Aleksei521/humidity-measure/image/board_up.jpg

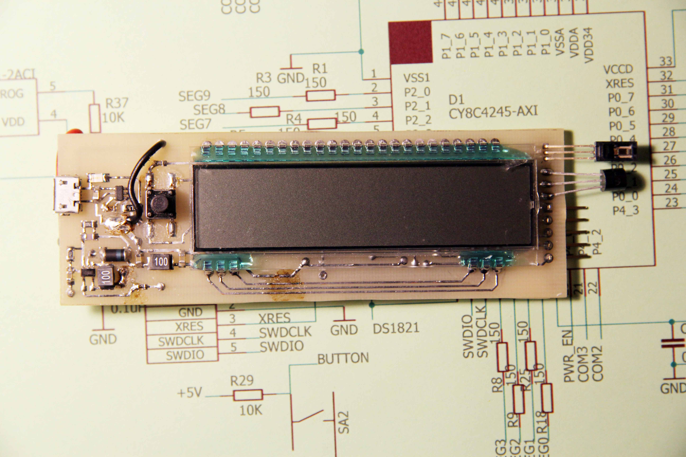
image/board_up.jpg
