Aleksei521/humidity-measure/image/board_back.jpg

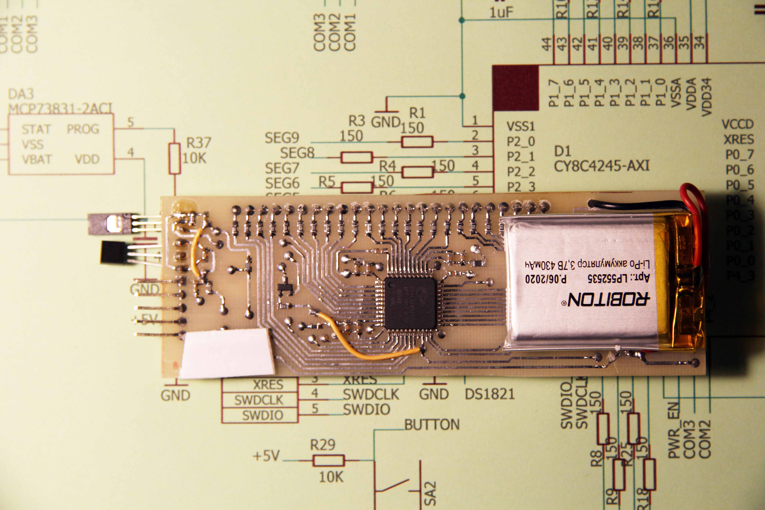
image/board_back.jpg
