Aleksei521/humidity-measure/README.md

# humidity-measure
Moisture and temperature meter on PSOC 4200 and segment LCD
https://habr.com/ru/post/547644/#habracut
