Aleksei521/humidity-measure/image/equip.jpg

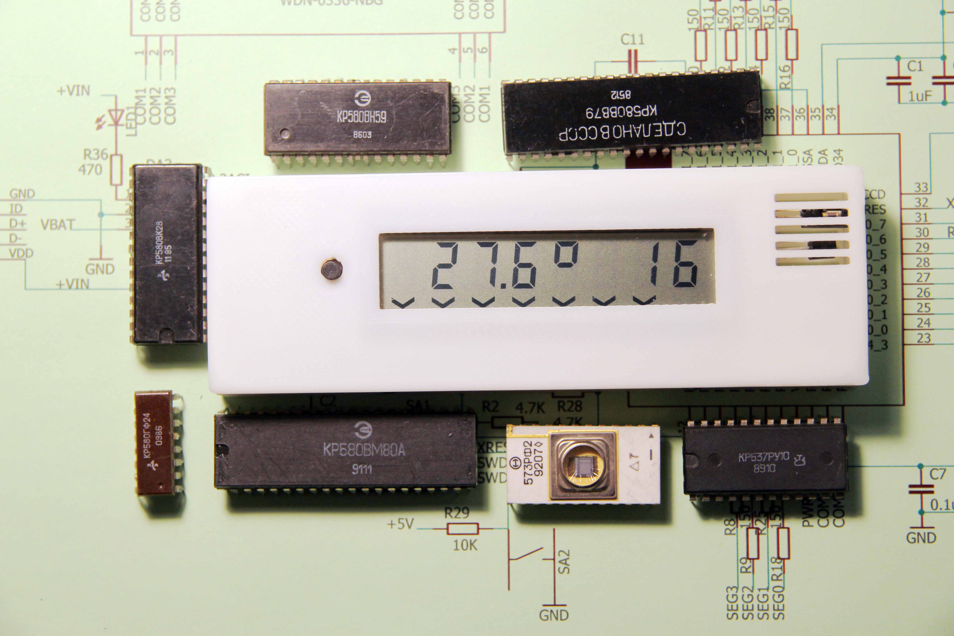
image/equip.jpg
