Aleksei521/humidity-measure/image/schematic.png

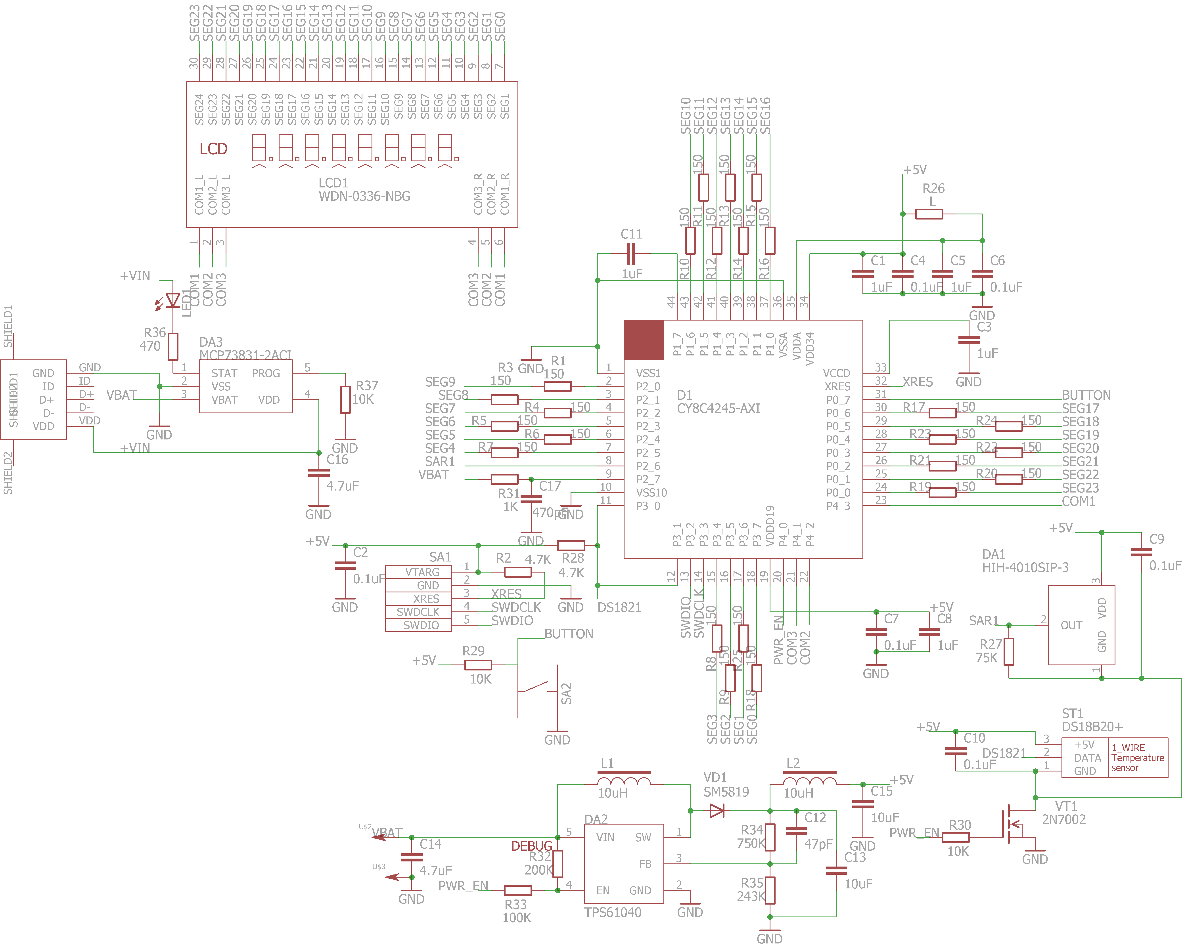
image/schematic.png
