Aleksei521/humidity-measure/Eagle/mcu.brd

## EAGLE design Eagle/mcu.brd (2021-03-17)

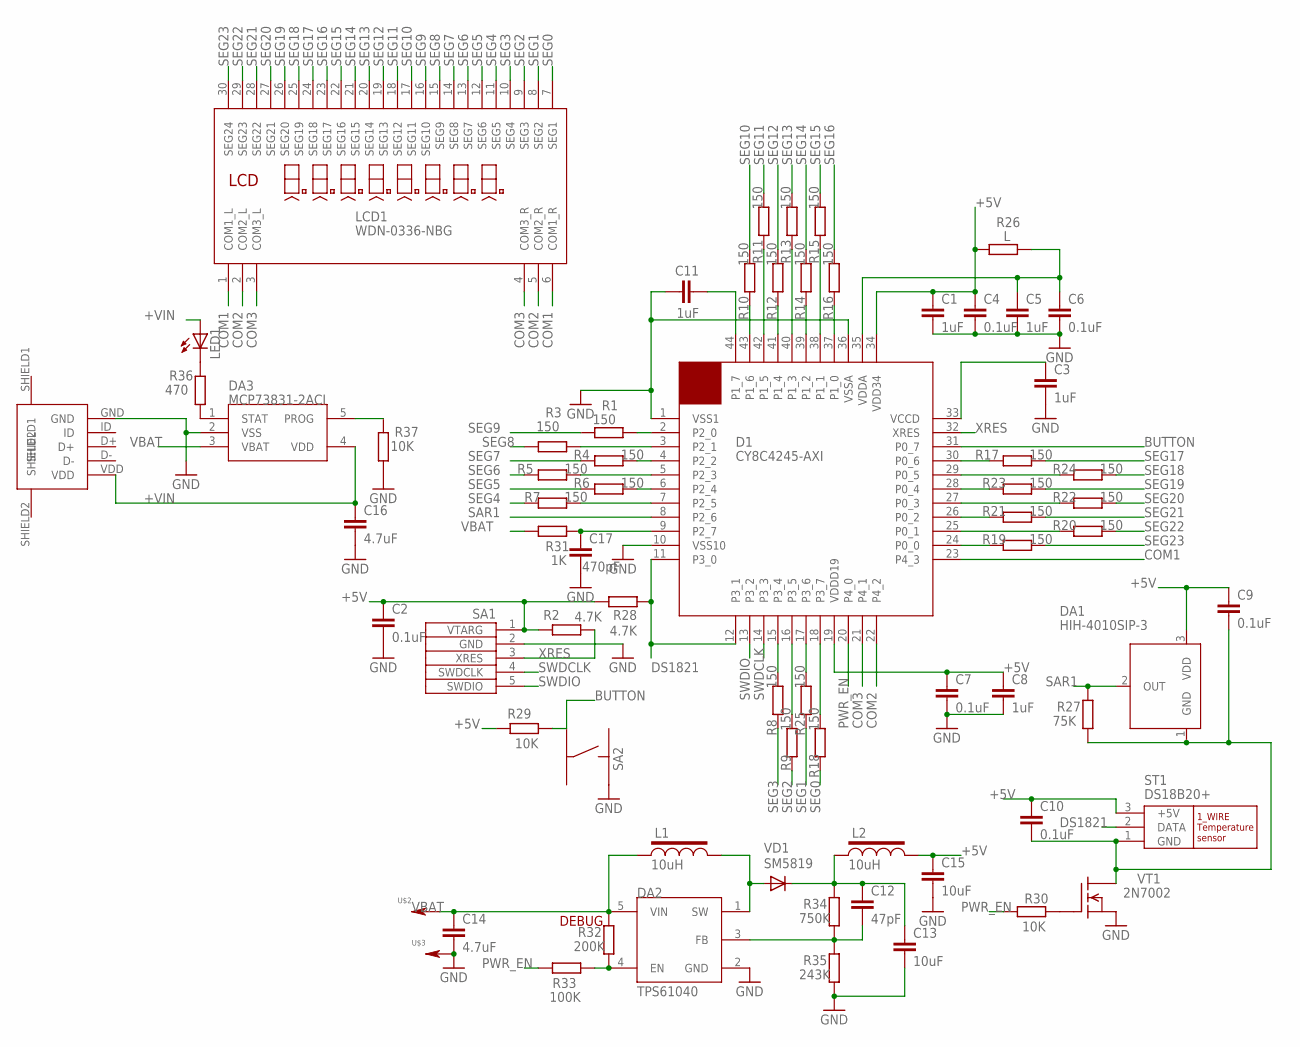
[picture p5: schematic mcu.sch]

Parts:
C1, C3, C5, C8, C11: 1uF; C0603
C2, C4, C6, C7, C9, C10: 0.1uF; C0603
C12: 47pF; C0805
C13, C15: 10uF; C0805
C14, C16: 4.7uF; C0805
C17: 470pF; C0603
D1: CY8C4245-AXI; TQFP44
DA1: HIH-4010SIP-3; SIP-3
DA2: TPS61040; SOT23-5L
DA3: MCP73831-2ACI; SOT23-5L
L1, L2: 10uH; SQC453226
LCD1: WDN-0336-NBG; WDN0336
LED1: LEDSMT1206; 1206
R1, R3, R4, R5, R6, R7, R8, R9, R10, R11, R12, R13, R14, R15, R16, R17, R18, R19, R20, R21, R22, R23, R24, R25: 150; R0603
R2, R28: 4.7K; R0603
R26: L; R0805
R27: 75K; R0603
R29, R30, R37: 10K; R0603
R31: 1K; R0603
R32: 200K; R0603
R33: 100K; R0603
R34: 750K; R0805
R35: 243K; R0805
R36: 470; R1206
SA1: SWDSWD-5; SWD-5
SA2: TACKT_BUTTONIIT-1102S; IIT-1102S
ST1: DS18B20+; TO92-
U$1: USB-MICRO; USB-MICRO-SMD
U$2: 1-PINHOME; 1-PIN_HOME
U$3: 1-PIN2_54; 1_PIN_2_54
VD1: SM5819; MELF-MLL41
VT1: 2N7002; SOT23

Connections:
+5V: C1.1, C2.1, C4.1, C7.1, C8.1, C9.1, C10.1, C15.1, D1.19 (VDDD19), D1.34 (VDD34), DA1.3 (VDD), L2.2 (L2), R2.2, R26.1, R28.2, R29.2, SA1.1 (VTARG), ST1.3 (+5V)
+VIN: C16.1, DA3.4 (VDD), LED1.A, U$1.VDD
BUTTON: D1.31 (P0_7), R29.1, SA2.SSR (2)
COM1: D1.23 (P4_3), LCD1.1 (COM1_L), LCD1.6 (COM1_R)
COM2: D1.22 (P4_2), LCD1.2 (COM2_L), LCD1.5 (COM2_R)
COM3: D1.21 (P4_1), LCD1.3 (COM3_L), LCD1.4 (COM3_R)
DS1821: D1.11 (P3_0), D1.12 (P3_1), R28.1, ST1.2 (DATA)
GND: C1.2, C2.2, C3.2, C4.2, C5.2, C6.2, C7.2, C8.2, C11.1, C13.2, C14.2, C15.2, C16.2, C17.2, D1.1 (VSS1), D1.10 (VSS10), D1.36 (VSSA), DA2.2 (GND), DA3.2 (VSS), R35.1, R37.1, SA1.2 (GND), SA2.SL (3), U$1.GND, U$3.P$1, VT1.2 (S)
unnamed: D1.2 (P2_0), R1.2
unnamed: D1.4 (P2_2), R4.2
unnamed: D1.6 (P2_4), R6.2
unnamed: D1.15 (P3_4), R8.2
unnamed: D1.3 (P2_1), R3.2
unnamed: D1.5 (P2_3), R5.2
unnamed: D1.7 (P2_5), R7.2
unnamed: D1.43 (P1_6), R10.1
unnamed: C3.1, D1.33 (VCCD)
unnamed: D1.42 (P1_5), R11.1
unnamed: D1.41 (P1_4), R12.1
unnamed: C5.1, C6.1, D1.35 (VDDA), R26.2
unnamed: D1.40 (P1_3), R13.1
unnamed: D1.39 (P1_2), R14.1
unnamed: D1.38 (P1_1), R15.1
unnamed: D1.37 (P1_0), R16.1
unnamed: D1.30 (P0_6), R17.1
unnamed: D1.29 (P0_5), R24.1
unnamed: D1.28 (P0_4), R23.1
unnamed: D1.16 (P3_5), R9.2
unnamed: D1.17 (P3_6), R25.2
unnamed: D1.18 (P3_7), R18.2
unnamed: D1.27 (P0_3), R22.1
unnamed: D1.26 (P0_2), R21.1
unnamed: D1.25 (P0_1), R20.1
unnamed: D1.24 (P0_0), R19.1
unnamed: C11.2, D1.44 (P1_7)
unnamed: C9.2, C10.2, DA1.1 (GND), R27.1, ST1.1 (GND), VT1.3 (D)
unnamed: R30.2, VT1.1 (G)
unnamed: C12.2, DA2.3 (FB), R34.1, R35.2
unnamed: DA2.4 (EN), R32.1, R33.2
unnamed: DA2.1 (SW), L1.2 (L2), VD1.A
unnamed: C12.1, C13.1, L2.1 (L1), R34.2, VD1.C
unnamed: DA3.1 (STAT), R36.1
unnamed: LED1.C, R36.2
unnamed: DA3.5 (PROG), R37.2
PWR_EN: D1.20 (P4_0), R30.1, R33.1
SAR1: D1.8 (P2_6), DA1.2 (OUT), R27.2
SAR2: C17.1, D1.9 (P2_7), R31.2
SEG0: LCD1.7 (SEG1), R18.1
SEG1: LCD1.8 (SEG2), R25.1
SEG2: LCD1.9 (SEG3), R9.1
SEG3: LCD1.10 (SEG4), R8.1
SEG4: LCD1.11 (SEG5), R7.1
SEG5: LCD1.12 (SEG6), R6.1
SEG6: LCD1.13 (SEG7), R5.1
SEG7: LCD1.14 (SEG8), R4.1
SEG8: LCD1.15 (SEG9), R3.1
SEG9: LCD1.16 (SEG10), R1.1
SEG10: LCD1.17 (SEG11), R10.2
SEG11: LCD1.18 (SEG12), R11.2
SEG12: LCD1.19 (SEG13), R12.2
SEG13: LCD1.20 (SEG14), R13.2
SEG14: LCD1.21 (SEG15), R14.2
SEG15: LCD1.22 (SEG16), R15.2
SEG16: LCD1.23 (SEG17), R16.2
SEG17: LCD1.24 (SEG18), R17.2
SEG18: LCD1.25 (SEG19), R24.2
SEG19: LCD1.26 (SEG20), R23.2
SEG20: LCD1.27 (SEG21), R22.2
SEG21: LCD1.28 (SEG22), R21.2
SEG22: LCD1.29 (SEG23), R20.2
SEG23: LCD1.30 (SEG24), R19.2
SWDCLK: D1.14 (P3_3), SA1.4 (SWDCLK)
SWDIO: D1.13 (P3_2), SA1.5 (SWDIO)
VBAT: C14.1, DA2.5 (VIN), DA3.3 (VBAT), L1.1 (L1), R31.1, R32.2, U$2.P$1
XRES: D1.32 (XRES), R2.1, SA1.3 (XRES)

Notes on the sheet:
DEBUG

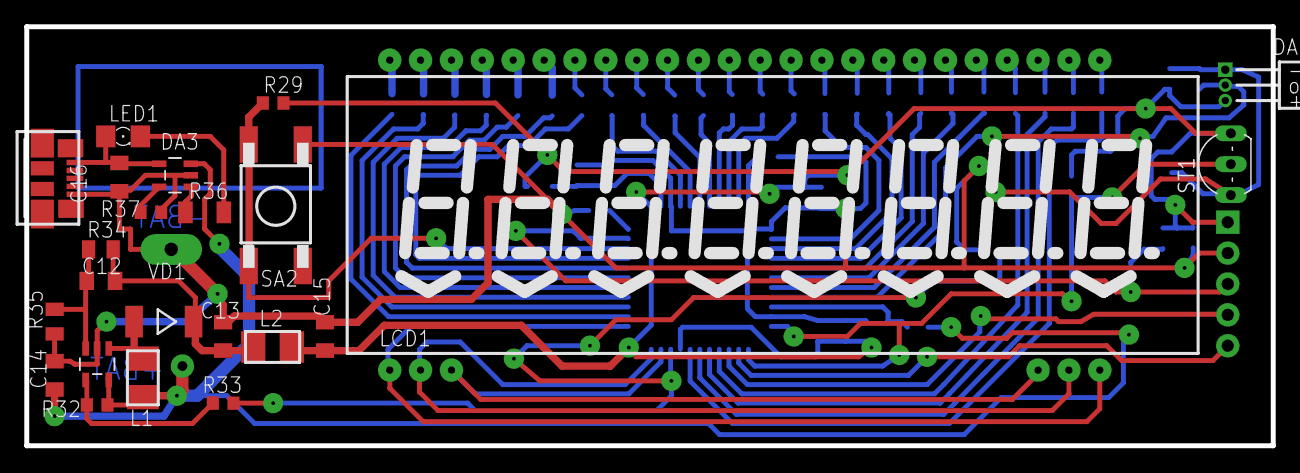
[picture p6: board mcu.brd from above]

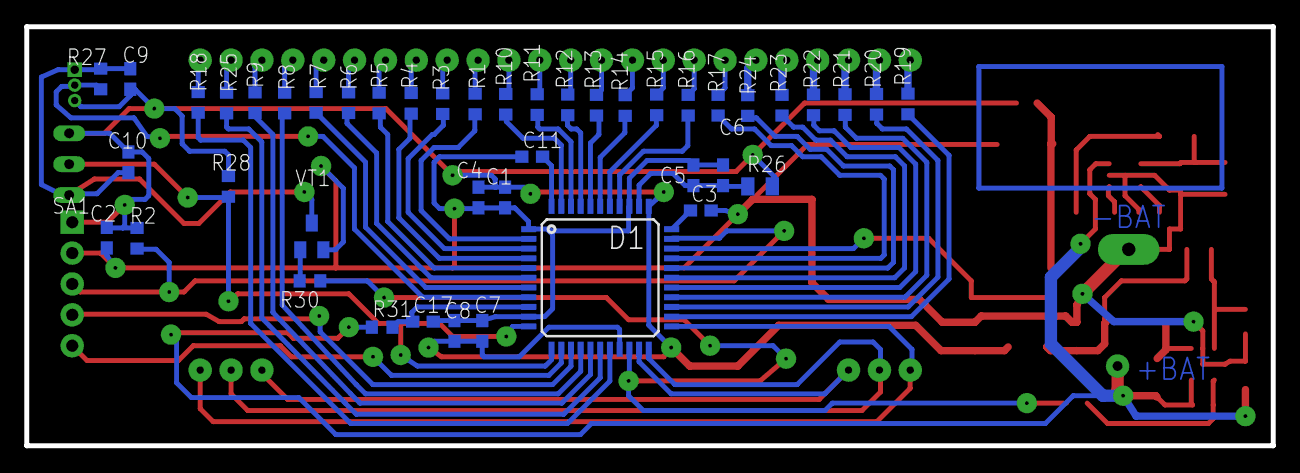
[picture p7: board mcu.brd from below]

Board: 2 copper layers, 102.5 x 34.5 mm, 70 parts (45 on the bottom side), 75 nets.
