Aleksei521/humidity-measure/psoc/hum_measure.cydsn/SegLCD_P4_v1_31/PSoC4/API/SegLCD_P4_PM.c

/*******************************************************************************
* File Name: `$INSTANCE_NAME`_PM.c
* Version `$CY_MAJOR_VERSION`.`$CY_MINOR_VERSION`
*
* Description:
*  This file provides the API source code for Power Management of the Segment
*  LCD component.
*
* Note:
*  None
*
********************************************************************************
* Copyright 2013-2015, Cypress Semiconductor Corporation.  All rights reserved.
* You may use this file only in accordance with the license, terms, conditions,
* disclaimers, and limitations in the end user license agreement accompanying
* the software package with which this file was provided.
*******************************************************************************/

#include "`$INSTANCE_NAME`.h"


/*******************************************************************************
* Function Name: `$INSTANCE_NAME`_SaveConfig
********************************************************************************
*
* Summary:
*  Saves user data. This API is called by `$INSTANCE_NAME`_Sleep() function.
*
* Parameters:
*  None.
*
* Return:
*  None.
*
*******************************************************************************/
void `$INSTANCE_NAME`_SaveConfig(void)
{
    /* Nothing to save for current version of the component */
}


/*******************************************************************************
* Function Name: `$INSTANCE_NAME`_RestoreConfig
********************************************************************************
*
* Summary:
*  Restores user data. This API is called by `$INSTANCE_NAME`_Wakeup() function.
*
* Parameters:
*  None.
*
* Return:
*  None.
*
*******************************************************************************/
void `$INSTANCE_NAME`_RestoreConfig(void)
{
    /* Nothing to restore for current version of the component */
}


/*******************************************************************************
* Function Name: `$INSTANCE_NAME`_Sleep
********************************************************************************
*
* Summary:
*  Prepares the component to enter Sleep mode.
*
* Parameters:
*  None.
*
* Return:
*  None.
*
*******************************************************************************/
void `$INSTANCE_NAME`_Sleep(void)
{
    `$INSTANCE_NAME`_SaveConfig();
}


/*******************************************************************************
* Function Name: `$INSTANCE_NAME`_Wakeup
********************************************************************************
*
* Summary:
*  Restores component after exiting Sleep mode.
*
* Parameters:
*  None.
*
* Return:
*  None.
*
*******************************************************************************/
void `$INSTANCE_NAME`_Wakeup(void)
{
    `$INSTANCE_NAME`_RestoreConfig();
}


/* [] END OF FILE */
