Aleksei521/humidity-measure/(commit log)

2021-03-17 posted on git
    posted on git
    [mcu.brd, mcu.sch]
2024-01-22 Сделал усреднение измерения влажности по 64 отсчетам
